Yan-yuze/probe-car/实现原理与答辩准备.md

# 探测小车 —— 实现原理与答辩准备

> 这份文档分两部分：**前半部分讲每个模块到底是怎么实现的**，后半部分是**模拟严苛答辩**（17 题，每题带答案）。
> 所有数值都来自代码实际取值和实机实测，不是估算。

---

# 第一部分：系统实现原理

## 一、系统总览

```
┌─────────────┐   MJPEG/HTTP    ┌──────────────────────┐
│  CyberCAM   │ ──────────────> │                      │
│ (摄像头板)   │     8081        │   电脑上的网页服务     │
└─────────────┘                 │      app.py          │
                                │        8765          │
┌─────────────┐   HTTP/WS       │                      │
│   ESP32-S3  │ <─────────────> │                      │
│             │     80 / 81     └──────────────────────┘
└──────┬──────┘                          ▲
       │ UART1 115200                    │ 浏览器
       │ GPIO17/18                       │
┌──────▼──────┐   I2C1 100kHz    ┌───────┴──────┐
│ STM32F103C8 │ ───────────────> │  电机驱动板   │
│             │   PB6/PB7        │  JGB37-520   │
│             │                  └──────────────┘
│             │   PWM 50Hz
│             │ ───────────────> 舵机 (PA6 / TIM3_CH1)
└─────────────┘
```

**为什么是三层而不是两层？**

电脑上的 `app.py` 不是多余的。ESP32 的 HTTP 服务在 WiFi 上，浏览器直接访问会遇到三个问题：跨域、断线重连、以及视频和控制在同一个页面里难以统一处理。电脑端做一层代理后：

- 浏览器只跟 `127.0.0.1:8765` 打交道，不存在跨域
- 视频（来自 CyberCAM）和控制（来自 ESP32）在同一个页面里统一呈现
- 可以在这里加**命令序号去重**（ESP32 上没有足够空间和便利做这件事）

**为什么控制链路要分两级超时？**

从浏览器到电机，中间隔了 WiFi、ESP32、UART、STM32 四个环节。任何一环断掉，如果没人兜底，小车就会带着上一次的速度一直跑下去。所以：

| 环节 | 超时 | 作用 |
| --- | --- | --- |
| 浏览器 | 每 180 ms 主动续发 | 证明"人还按着" |
| ESP32 | 500 ms 收不到浏览器消息 → 发 STOP | 兜住 WiFi 断、网页崩溃 |
| STM32 | 700 ms 收不到 ESP32 字节 → 主动刹车 | 兜住串口线断、ESP32 死机 |

180 < 500 < 700，留了足够余量，正常操作绝不会误触发。

---

## 二、STM32 侧实现原理

### 2.1 时钟树：72 MHz 是怎么来的

板上晶振 HSE = 8 MHz。`system_stm32f10x.c` 里的启动流程：

```
HSE 8MHz ──> PLL ×9 ──> SYSCLK 72MHz
                            │
              ┌─────────────┼─────────────┐
           AHB /1        APB2 /1       APB1 /2
              72MHz        72MHz        36MHz
              HCLK         PCLK2        PCLK1
```

关键在 **APB1 分频系数不为 1 时，挂在该总线上的定时器时钟 = PCLK1 × 2**。所以：

```
TIM3 时钟 = PCLK1 × 2 = 36MHz × 2 = 72MHz
```

这条规则是 STM32 特有的（目的是让定时器在主频降低时仍能获得较高计数频率），**也是答辩最容易问倒人的地方**。

### 2.2 SysTick：1 ms 毫秒基准

```c
SystemCoreClockUpdate();                    // 从 RCC 寄存器反推当前主频
SysTick_Config(SystemCoreClock / 1000);     // 72000 - 1 装入 LOAD
```

`SysTick` 是 Cortex-M3 内核自带的 24 位递减计数器，重装载值 71999，每 72000 个内核周期中断一次 = 1 ms。中断里只做 `g_ms_tick++`，`millis()` 直接返回这个变量，`Delay_ms()` 用无符号减法 `(uint32_t)(millis() - start) < ms` 判断——**用减法而不是比较大小，是为了让计数器溢出（约 49.7 天）时逻辑依然正确**。

### 2.3 电机驱动：I2C1 + 寄存器映射

驱动板是 JGB37-520 闭环电机，7 位地址 **0x26**，用寄存器方式配置：

| 寄存器 | 地址 | 内容 | 本车取值 |
| --- | --- | --- | --- |
| 类型 | 0x01 | u8 | 1（520 型号） |
| 死区 | 0x02 | u16 | 1500 |
| 每圈脉冲 | 0x03 | u16 | 11 |
| 减速比 | 0x04 | u16 | 30 |
| 轮径 | 0x05 | float | 68.0 mm |
| **速度** | 0x06 | 4×i16 大端 | 闭环速度 |
| **PWM** | 0x07 | 4×i16 大端 | 直接占空比 |

两个设计点：

1. **速度和 PWM 用不同寄存器**。正常行驶写 0x06（走闭环，编码器反馈保证 80 mm/s 真实线速度）；`Car_StopAll()` 写 0x07 全 0（直接切断 PWM）。如果停车也走速度环，PID 在收到 0 之后仍可能输出小占空比让车蠕动，**直接给 PWM 0 才是硬停**。

2. **左右电机符号相反**。两个电机镜像安装，所以 `RIGHT_WHEEL_FORWARD_SIGN = -1`、`LEFT_WHEEL_FORWARD_SIGN = +1`。差速转弯就是 `Car_SetWheelSpeed(-speed, speed)`——左轮后退、右轮前进，原地转。

3. **每个等待都有超时**。`wait_flag()` 和 `wait_event()` 都限时 50 ms，且检查 AF（应答失败）标志。原因见答辩第 12 题。

### 2.4 舵机：TIM3_CH1 硬件 PWM

**角度 → 脉宽**：

```c
pulse = 1000 + (angle * 1000 + 90) / 180;   // 单位 µs
```

- 0° → 1000 µs，180° → 2000 µs，线性映射
- 那个 `+90` 是**四舍五入**：除以 180 之前加 180 的一半，避免整数除法一律截断带来的系统偏小

**定时器配置**（寄存器直配，不经过标准库封装）：

```c
TIM3->PSC   = 72 - 1;        // 72MHz / 72 = 1MHz → 1 个计数 = 1µs
TIM3->ARR   = 20000 - 1;     // 20000 × 1µs = 20ms → 50Hz
TIM3->CCMR1 = (CCMR1 & 0xFF00) | 0x68;   // OC1M=110(PWM模式1) | OC1PE=1
TIM3->CCER |= TIM_CCER_CC1E;             // 通道 1 输出使能，高电平有效
TIM3->CCR1  = angle_to_pulse(88);        // 初始脉宽
TIM3->EGR    = TIM_EGR_UG;               // 产生更新事件，立刻载入 PSC/ARR
TIM3->CR1   |= TIM_CR1_ARPE | TIM_CR1_CEN;  // ARR 预装载 + 启动计数
```

**CCMR1 的 0x68 怎么来的**：bit4~6 是 OC1M（输出比较模式），`110` = PWM 模式 1；bit3 是 OC1PE（预装载使能）。`(0b110 << 4) | (1 << 3) = 0x60 | 0x08 = 0x68`。

**PA6 引脚配置**：GPIOA_CRL 的 bit27~24 = `0b1011`，即 CNF=10（复用推挽）、MODE=11（50 MHz 输出）。

**为什么不调用 `GPIO_PinRemapConfig()`**：TIM3 复位后默认就是不重映射，CH1 本来就在 PA6，没必要碰 AFIO。而且标准库那个函数的 DISABLE 分支里有一行 `tmpreg |= ~DBGAFR_SWJCFG_MASK`，会把 `AFIO_MAPR` 的 SWJ_CFG 位写成 `111`——一个多余的副作用，能避就避。

### 2.5 USART2：中断 + 主循环分工

- PA2 = TX（复用推挽），PA3 = RX（**上拉输入**）
- 115200 8N1，中断只做三件事：判标志、读数据、更新状态变量

中断里**绝不做**的事：I2C 通信、`printf`、延时。115200 下每个字节约 86.8 µs，中断必须在下一个字节到达前退出，否则 ORE（溢出）丢数据。

**协议帧**：

| 方向 | 帧 | 含义 |
| --- | --- | --- |
| ESP32→STM32 | `F/B/L/R/S\n` | 前进/后退/左转/右转/停 |
| ESP32→STM32 | `Pddd\n` | 舵机目标（30~150） |
| ESP32→STM32 | `Q\n` / `V\n` | 查询舵机角度 / 查询版本 |
| STM32→ESP32 | `A<cmd>\n` / `E<cmd>\n` | 执行成功 / 失败 |
| STM32→ESP32 | `T\n` | 失联超时通知 |
| STM32→ESP32 | `M0\n` / `M1\n` | 电机板未就绪 / 就绪 |
| STM32→ESP32 | `Pddd\n` | 当前舵机角度回执 |
| STM32→ESP32 | `V80SG90\n` | 固件版本 |
| STM32→ESP32 | `R\n` | 上电广播 |

**`Pddd` 帧解析是个状态机**，三个细节：

1. **STOP 优先级最高**。`'S'` 的判断放在 servo 帧分支**之前**，所以即使正在收 `P1`（半帧），来一个 `S` 也会立刻被当成停车命令处理——不会被半截舵机帧吞掉。

2. **坏帧丢弃而不是容错**。收到非数字非回车换行的字符时把 `digits` 设成 4（超过 3 就永远不会被接受），后续字符一律忽略直到换行。这样 `P1a2\n` 不会变成 `P12`。

3. **100 ms 帧超时**。如果 `P` 之后 100 ms 内没收全（比如串口被拔了一瞬间），主动放弃这一帧。否则一个半截帧会一直挂在那儿，把后面所有指令都吃掉。

### 2.6 失联保护：为什么是"停止发脉冲"

```c
#if SERVO_HOLD_TIMEOUT_MS > 0
if (!Servo_IsReleased() &&
    (uint32_t)(millis() - g_last_servo_command_ms) > SERVO_HOLD_TIMEOUT_MS) {
    Servo_Release();                     // CCR1 = 0
    servo_requested = 1;                 // 顺带回执给 ESP32
}
#endif
```

`Servo_Release()` 把 `CCR1` 写 0，PWM 模式 1 下 0% 占空比 = **PA6 恒低，一个脉冲都没有**。

**为什么不发 1500 µs**：因为连续旋转舵机的真实停止点每一颗都不一样。本车实测在 **1489 µs**，不是标称的 1500 µs。如果超时发 1500 µs，舵机不会停，而是以很小的偏移量慢慢爬。既然固件猜不准，**最安全的做法就是干脆不发脉冲**——舵机收不到脉冲就不驱动电机，一定停。

---

## 三、ESP32 侧实现原理

### 3.1 引脚选择的约束

板子是 YD-ESP32-S3 N16R8，`platformio.ini` 里 `board_build.arduino.memory_type = qio_opi`——**八线 PSRAM**。这决定了一批引脚不能用：

| 引脚 | 占用者 | 能否使用 |
| --- | --- | --- |
| 26~32 | SPI Flash | ❌ |
| **33~37** | **八线 PSRAM** | ❌ **本板特有** |
| 19 / 20 | 原生 USB D-/D+ | ❌ |
| 43 / 44 | UART0（板载 USB 转串口） | ❌ |
| 0 / 45 / 46 | strapping | ❌ |
| 48 | 板载 RGB 灯 | ❌ |
| **17 / 18** | 与 STM32 的 UART1 | ✅ 本项目占用 |
| **8 / 9** | AHT10 的 I2C | ✅ 本项目占用 |

`HardwareSerial carSerial(1)` 建的 UART1 通过 `carSerial.begin(baud, SERIAL_8N1, RX, TX)` 重映射到 18/17。

另外 `ARDUINO_USB_CDC_ON_BOOT=0`，所以 `Serial` 走的是 UART0（板载 USB 转串口芯片），日志在 COM7 上能看到。

### 3.2 WiFi 双模与状态机

```c
WiFi.mode(useStation ? WIFI_AP_STA : WIFI_AP);
WiFi.softAP(CAR_AP_SSID, CAR_AP_PASSWORD, 6, false, 2);   // 信道 6，2.4GHz
WiFi.begin(WIFI_SSID, WIFI_PASSWORD);                     // 8 秒超时
```

**同时开热点和 STA**，好处是：连不上路由器时还能用自建热点 `192.168.4.1` 控制，不会变砖。`useStation` 由 `strlen(WIFI_SSID) > 0` 决定——**留空就退化成纯 AP 模式**，这也是仓库里默认的配置。

### 3.3 与 STM32 的通信与状态推断

```c
bool isStm32Online() { return stm32EverSeen && (millis() - lastStm32RxMs <= 2500UL); }
bool hasServoFirmware() { return stm32Version == "V80SG90"; }
```

两个关键设计：

1. **`stm32EverSeen` 和"最后一次收到时间"分开**。刚上电时 STM32 还没说话，不应该报"掉线"（会误报）。只有**曾经收到过**、且**超过 2.5 秒没再收到**才算掉线。

2. **用固件版本号做能力门控**。`hasServoFirmware()` 比对 `V80SG90`。旧版 STM32（`V80S`）没有舵机功能，网页会**禁用舵机按钮**而不是发过去一个它看不懂的命令。这种"能力协商"比"发了再说"健壮得多。

另外 `processStm32Line()` 收到 `R`（STM32 上电广播）时会**清空缓存的版本号和角度**——所以热插拔 STM32 之后 ESP32 会自动重新同步，不需要手动重启 ESP32。

### 3.4 AHT10 温湿度驱动

**通信协议**（I2C 地址 0x38）：

| 步骤 | 字节 | 说明 |
| --- | --- | --- |
| 初始化 | `0xE1 0x08 0x00` | AHT10 的校准命令 |
| 初始化 | `0xBE 0x08 0x00` | AHT20 的校准命令（备用） |
| 触发测量 | `0xAC 0x33 0x00` | 每次读数据前都要发 |
| 等待 | ≥ 80 ms | 代码取 90 ms 留余量 |
| 读数据 | 6 字节 | 见下 |

**状态字节两个位**：bit7 = busy（还在测量），bit3 = calibrated（已校准）。

**6 字节数据格式**：

```
b[0] = 状态
b[1] b[2] b[3]高4位  → 湿度 20 位
b[3]低4位 b[4] b[5]  → 温度 20 位
```

```c
rawHum  = (b[1] << 12) | (b[2] << 4) | (b[3] >> 4);              // 20 位
rawTemp = ((b[3] & 0x0F) << 16) | (b[4] << 8) | b[5];           // 20 位

humidity    = rawHum  * 100.0f / 1048576.0f;        // 2^20 = 1048576
temperature = rawTemp * 200.0f / 1048576.0f - 50.0f;
```

温湿度和温度**共用 b[3] 这一个字节**（各占 4 位），这是 AHT10 数据手册里最容易写错的地方。

**两个实现要点**：

1. **兼容 AHT20**。市面上标着 AHT10 的模块里装的经常其实是 AHT20，两者地址和读数据格式完全一样，只有初始化命令不同（0xE1 vs 0xBE）。驱动两个都试，谁把 calibrated 位置起来就用谁。

2. **非阻塞状态机**。AHT10 一次测量要 80 ms。如果用 `delay(80)`，这 80 ms 里 HTTP 服务器不响应、串口不转发，网页会卡顿。所以拆成状态：

   ```
   IDLE ──(到 2 秒)──> 发 0xAC ──> WAITING ──(过 90 ms)──> 读 6 字节 ──> IDLE
   ```

   每次 `loop()` 只推进一步，主循环始终保持响应。

3. **I2C 扫描器**。启动时扫 0x08~0x77，把找到的地址放进状态 JSON。传感器没接时网页直接显示"I2C 上扫到：无"，**把接线问题变成看得见的信息**，而不是一句"读取失败"。

---

## 四、电脑端实现原理

### 4.1 app.py：代理 + 防重放

`app.py` 只用 Python 3 标准库（`http.server.ThreadingHTTPServer`），不装任何第三方包。

**命令序号去重**是它最有价值的部分：

```python
client_id = payload.get("client_id")     # 每个浏览器标签页一个 UUID
sequence  = payload.get("sequence")      # 单调递增

if sequence <= sequence_map.get(client_id, 0):
    return {"ok": True, "skipped": True}   # 旧命令直接丢弃，不转发
sequence_map[client_id] = sequence
```

解决的问题是**乱序**：按住前进突然松手，`STOP` 和前一个 `FORWARD` 可能几乎同时发出，网络上到达顺序不保证。如果 `STOP` 先到、`FORWARD` 后到，车就会**松开手还在跑**。有了序号，`FORWARD` 的序号比 `STOP` 小，直接被丢弃。

**运动和舵机用两把独立的锁 + 两张独立的序号表**。如果共用一把锁，一个慢的舵机请求会阻塞住 `STOP`；共用一张表则舵机的序号会把停车指令挤掉。

**安全校验**：要求 `Content-Type: application/json` **且** `X-Car-UI: 1` 自定义头。别的网页想通过 CSRF 让小车动起来时，浏览器发跨域请求会先发 CORS 预检，自定义头过不了，请求根本发不出来。请求体限制 1~128 字节。

**视频转发**用 `source.read1(16 * 1024)` 而不是 `read(16384)`：`read` 会一直等到凑满 16 KB 才返回，会引入额外延迟；`read1` 有多少返回多少。

### 4.2 前端：按住才转是怎么实现的

```js
servoLeft.addEventListener('pointerdown', e => {
  servoLeft.setPointerCapture?.(e.pointerId);   // 手指滑出按钮也能收到 pointerup
  startServo('LEFT');                           // 立刻发一次 + 每 180ms 续发
});
window.addEventListener('pointerup', e => { if (e.pointerId === activeServoPointerId) stopServo(); });
window.addEventListener('blur', () => stopServo(true));
document.addEventListener('visibilitychange', () => { if (document.hidden) stopServo(true); });
window.addEventListener('pagehide', () => stopServo(true));
```

四个细节：

1. **`setPointerCapture`**：手指按住按钮后滑出去再松开，如果不捕获指针，`pointerup` 会派发给别的元素，`stopServo` 就收不到，舵机会一直转。

2. **`pointerup` 绑在 window 上而不是按钮上**：在页面任何地方松手都能停。

3. **`blur` / `visibilitychange` / `pagehide` 三重兜底**：切到别的窗口、按手机锁屏、直接关标签页，都会停。`pagehide` 时 fetch 带 `keepalive: true`，保证这个最后的 `STOP` 在页面卸载过程中也能发出去。

4. **`servoPending` / `servoQueued` 合并请求**：同一时刻只允许一个请求在飞，飞行期间的变化只记一个"待发"标记。这样既不会堆积请求，又**保证停止指令不会被丢弃**。

### 4.3 舵机方向与转速的标定过程

连续旋转舵机的物理规律：

```
转速 ∝ |脉宽 − 真实停止点|
方向 = sign(脉宽 − 真实停止点)
```

一开始用对称于 **1500 µs** 的两个值（1417 / 1583）。如果舵机的真实停止点正好是 1500 µs，两边速度就该一样。**实测右转偏快**，说明停止点比 1500 µs 低。

设真实停止点比 1500 µs 低 `d`：

```
左转偏移 = 83 − d      右转偏移 = 83 + d
速度比 = (83+d)/(83−d)
```

"只快一点点"约对应 1.13 倍，解得 `d ≈ 5~11 µs`。于是把基准从 **90（1500 µs）调到 88（1489 µs）**：

| 按钮 | 角度 | 脉宽 | 离真实停止点 |
| --- | --- | --- | --- |
| 左转 | 103 | 1572 µs | 83 µs |
| 停止 | 88 | 1489 µs | 0 |
| 右转 | 73 | 1406 µs | 83 µs |

两边偏移相等 → 转速一致。

**代码上的关键约束**：左右两个方向**必须**由同一个基准加减同一个偏移得出：

```js
if (servoRotating === 'LEFT')  return clampServoAngle(SERVO_STOP_ANGLE + SERVO_SPAN);
if (servoRotating === 'RIGHT') return clampServoAngle(SERVO_STOP_ANGLE - SERVO_SPAN);
```

曾经出过一次 bug：两个方向写成两个独立常量，`SERVO_RIGHT_ANGLE` 被误改成和左转相同的值，结果两个按钮发出**完全相同**的脉宽，左右都往同一边转。用"基准 ± 偏移"的形式，这种错误在结构上就写不出来了。

### 4.4 关于"回正"

**连续旋转舵机做不到精确回正，这是硬件限制。** 它的内部角度电位器在改成 360° 时已经被拆掉/短接，控制环调节的是**速度**而不是**位置**——它没有任何绝对位置参考，不知道自己转到哪了。

理论上只有两种近似：按时间对冲（累计转动时长再反向转同样久，误差会累积），或者往机械限位顶（每次都顶到同一个位置，精确但会让舵机堵转）。**要精确回位只能换普通位置舵机**（带电位器反馈的那种）。

---

## 五、CyberCAM 视频服务

跑在摄像头板上，也是纯标准库 + OpenCV。

**`LatestJpeg` 是核心**——只保存最新一帧：

```python
def publish(self, jpeg):        # 采集线程
    with self.condition:
        self.jpeg = jpeg
        self.sequence += 1
        self.condition.notify_all()

def wait_after(self, sequence, stop):   # 推流线程
    with self.condition:
        if self.sequence <= sequence and not stop.is_set():
            self.condition.wait(timeout=1.0)
        return self.sequence, self.jpeg
```

**为什么只存最新一帧**：如果做成队列，浏览器一卡，帧就在队列里堆积，越积越多，最后延迟几秒甚至内存爆掉。只存最新帧的话，慢的客户端会**主动丢帧**而不是积压——延迟恒定，这才叫实时。

`/health` 返回 `frames` 和 `age_ms`，`ok` 要求 `age_ms < 2000`——**用"数据有多旧"判断健康，而不是"有没有数据"**。摄像头卡死但进程还活着的情况，只有看 age 才能发现。

采集节奏用 `next_frame += period` 再 `stop.wait(remaining)`：累加式计时避免误差累积，`stop.wait` 代替 `sleep` 让退出信号能立刻响应。

---

# 第二部分：答辩模拟（17 题）

> 下面是"如果不是自己写的就答不上来"的问题。每题先给答案，再给**常见错误回答**（老师会追问的地方）。

---

## Q1. 你的 TIM3 计数频率是多少？怎么算出来的？

**答**：1 MHz，也就是一个计数 = 1 微秒。

TIM3 挂在 APB1 上。系统时钟 72 MHz，APB1 分频系数是 2，所以 PCLK1 = 36 MHz。但 STM32 有个规则：**APB 分频系数不为 1 时，该总线上定时器的时钟等于 APB 时钟的 2 倍**，所以 TIM3 的时钟是 72 MHz。

```c
TIM3->PSC = 72 - 1;      // 72MHz / 72 = 1MHz
TIM3->ARR = 20000 - 1;   // 20000 × 1µs = 20ms → 50Hz
```

> ❌ 常见错误：直接说 36 MHz。这会把 PWM 周期算成 40 ms（25 Hz），舵机会抖。

---

## Q2. 为什么 PSC 要写 71 而不是 71.0 或者 72000000/1000000？

**答**：因为分频器是"计数值"语义，不是"倍数"语义。STM32 的预分频器是**从 0 开始计数到 PSC 然后溢出**，所以实际分频比 = `PSC + 1`。要 72 分频就得写 71。

我在代码里没有写死 71，而是算出来的，这也是有意为之：

```c
clock = tim3_clock();                       // 读 RCC 反推实际时钟
TIM3->PSC = (uint16_t)(clock / 1000000U - 1U);
```

这样即使换一颗晶振不同的板子、或者 HSE 起振失败自动降级到 HSI 64 MHz，PWM 频率依然是准确的 50 Hz，不需要改代码。

> 追问：如果忘了减 1 会怎样？→ PSC = 72 → 73 分频 → 986 kHz → 周期变成 20.28 ms → 49.3 Hz。误差不大但没必要。

---

## Q3. 角度转脉宽的公式里，为什么除以 180 之前要先加 90？

**答**：那是**四舍五入**。

```c
pulse = 1000 + (angle * 1000 + 90) / 180;
```

0°~180° 对应 1000 µs~2000 µs，所以 1° = 1000/180 ≈ 5.556 µs。整数除法是**向下取整**，如果直接除，每一档都会偏小最多 1 µs，而且误差方向一致（有系统性偏差）。先加 180 的一半（90）再除，就变成四舍五入，误差变成 ±0.5 µs 且不偏。

代入验证：angle = 88 → 1000 + (88000+90)/180 = 1000 + 489 = **1489 µs**。

---

## Q4. 脉宽 1500 µs 是舵机的中位，那你为什么用 1489 µs 当停止点？

**答**：因为**1500 µs 是标称值，不是这颗舵机的实际值**。

连续旋转舵机的转速正比于 |脉宽 − 真实停止点|。我一开始按标称值对称下发 1417 µs（左）和 1583 µs（右），两边离 1500 µs 都是 83 µs，理论上转速应该完全一样。**实测右转明显偏快**，说明真实停止点不在 1500 µs。

设真实停止点比 1500 µs 低 d，则左转偏移 = 83−d，右转偏移 = 83+d。"只快一点点"约对应速度比 1.13，解 `(83+d)/(83−d) = 1.13` 得 d ≈ 5~11 µs。

所以把基准从 90（1500 µs）挪到 **88（1489 µs）**，两个方向变成 ±83 µs 对称分布，转速就一致了。

> 追问：你怎么确定是 5~11 而不是别的？→ 我无法测量，只能靠"快一点点"这个主观描述反推。所以这是**标定值**，不是理论值。如果还差一点，往 87 或 89 调一格（1 个角度 ≈ 5.6 µs）就行。

---

## Q5. 你的代码里没有调用 GPIO_PinRemapConfig，TIM3_CH1 为什么会在 PA6 上？

**答**：因为**不重映射就是默认状态**。

STM32F103 的 TIM3 复用功能有三档：不重映射（CH1~CH4 = PA6/PA7/PB0/PB1）、部分重映射（PB4/PB5/PB0/PB1）、完全重映射（PC6~PC9）。这个设置存在 `AFIO_MAPR` 的 TIM3_REMAP 位（bit11:10），**复位值是 0 = 不重映射**，所以 CH1 天生就在 PA6。

我刻意不调用 `GPIO_PinRemapConfig()` 是因为看了标准库的实现，它的 DISABLE 分支里有这么一行：

```c
tmpreg |= ~DBGAFR_SWJCFG_MASK;    // 结果是把 AFIO_MAPR 的 bit24~27 置 1
```

而 `AFIO_MAPR` 的 bit26:24 是 **SWJ_CFG**——控制 JTAG/SWD 调试口的配置位。虽然 `111` 这个值在手册里是"no effect"（保留值，不生效），但这是一个**和重映射毫无关系的副作用**，而且一旦哪天 ST 改了保留值的含义就会出问题。既然默认值就是我要的，那就不碰它。

> 这一题最能看出是不是自己写的：只看"代码能跑"的人不会注意到那个副作用。

---

## Q6. 舵机失联保护，为什么是"停止发脉冲"而不是"发 1500 µs 让它停"？

**答**：因为 1500 µs **不是这颗舵机的停止点**（见 Q4，实测是 1489 µs）。

`Servo_Release()` 把 `CCR1` 写 0，PWM 模式 1 下 0% 占空比 = **PA6 恒低，一个脉冲都没有**。舵机的控制芯片收不到脉冲就不驱动电机，一定会停。

如果超时发 1500 µs，舵机会收到一个偏离真实停止点 11 µs 的脉宽，它会**以很小的速度慢慢爬**——看起来像"停不下来"，而且是持续堵转，对舵机不好。

固件猜不准每颗舵机的真实停止点，**"不发脉冲"是唯一不依赖这个未知量的安全动作**。

> 代价：停下来后没有保持力矩。对连续旋转舵机没影响；如果以后换成位置舵机，要把 `SERVO_HOLD_TIMEOUT_MS` 改成 0 关掉这个保护。

---

## Q7. 你的两级失联保护具体是怎么配合的？为什么是 180 / 500 / 700 这三个数？

**答**：

| 环节 | 时间 | 触发条件 | 动作 |
| --- | --- | --- | --- |
| 浏览器 | 180 ms | 按住期间定时续发 | 证明"人还按着" |
| ESP32 | 500 ms | 收不到浏览器消息 | 向 STM32 发 STOP |
| STM32 | 700 ms | 收不到 ESP32 的字节 | 主动刹车并停车 |

设计依据是**层层留余量**：

- 180 ms 是续发周期，必须**明显小于** 500 ms，否则网络抖动一下 ESP32 就误判了。留了 2.7 倍余量。
- ESP32 的 500 ms 必须**小于** STM32 的 700 ms。这样正常失联时是 ESP32 先主动停车（分层优雅），STM32 的 700 ms 只是最后一道防线（串口线断了、ESP32 死机时才触发）。
- 同时 180 ms 也不能太短，否则每秒钟 5~6 个 HTTP 请求，ESP32 的 WebServer 会吃力。

**还有一个容易被忽略的点**：`Pddd`（舵机命令）和 `Q`/`V`（查询）**不刷新行驶超时计时器**。否则用户在舵机面板上一直拖动滑条，就会有无穷多个舵机命令不停地喂狗，把"车该停了"这件事永远推迟下去。舵机指令绝对不能成为让车继续行驶的理由。

> 这是安全设计上的一个真实陷阱，不是理论问题。

---

## Q8. USART2 中断服务函数里为什么不能调用 I2C 或者 printf？

**答**：因为它必须在**下一个字节到达之前**退出。

115200 baud 下，1 位 = 1/115200 ≈ 8.68 µs，一个字节（1 起始位 + 8 数据位 + 1 停止位）= **86.8 µs**。

中断里的 `USART_ReceiveData()` 会把 RXNE 标志清掉，下一个字节再进来时如果 RXNE 还是 1（说明上次的没被读走），硬件就会置 **ORE（溢出错误）**，那个字节**永久丢失**。

如果在中断里做一次 I2C 传输，光等待事件就可能几毫秒——相当于几十个字节全丢。`printf` 同理，串口输出本身就要排队发送。

所以我的中断里只有：

```c
void USART2_IRQHandler(void) {
    if (USART_GetITStatus(USART2, USART_IT_RXNE) != RESET) {
        char c = (char)(USART_ReceiveData(USART2) & 0xFF);
        // ... 纯内存操作的帧状态机 ...
    }
}
```

真正的活（I2C 下发、回执发送）全在 `main()` 的主循环里，通过 `volatile` 标志位交接。**中断只负责"记下来"，主循环负责"干活"。**

---

## Q9. 描述一下你解析 `P090\n` 这个舵机帧的完整过程，包括出错怎么处理。

**答**：是一个跨多次中断的**状态机**，状态存在全局变量里：

```
g_servo_receiving    是否在帧中
g_servo_digits       已收数字个数
g_servo_value        累加值
g_servo_frame_started_ms  帧开始时间
```

流程：

1. 收到 `'P'` → `receiving=1, digits=0, value=0`，记录开始时间
2. 收 `'0'` → 是数字且 digits<3 → `value = 0*10+0 = 0, digits=1`
3. 收 `'9'` → `value = 0*10+9 = 9, digits=2`
4. 收 `'0'` → `value = 9*10+0 = 90, digits=3`
5. 收 `'\n'` → 检查 `digits==3 && 30<=value<=150` → 通过，置 `g_servo_pending=1`

**三种异常**：

| 情况 | 处理 |
| --- | --- |
| 收到非数字字符（如 `P1a2\n`） | `digits = 4`（超过 3），后续一律忽略到换行，整帧作废 |
| 收满 3 位后还有第 4 位（如 `P1234\n`） | digits 已经是 3，不再累加，也不置错——但换行时会因为长度不是 3 而拒收 |
| 帧收了一半就断了 | 进中断时检查 `millis() - frame_started_ms > 100`，超时则 `receiving=0` 放弃这一帧 |

**最关键的一点**：`'S'` 的判断放在整个 servo 分支**之前**：

```c
if (command == 'S') {              // 最高优先级，先判
    g_servo_receiving = 0;         // 顺手把半截舵机帧丢掉
    ...
} else if (g_servo_receiving) {    // 然后才是帧内字符
    ...
}
```

这样"停车"永远不会被一个半截舵机帧挡住。如果把 `'S'` 放在帧内分支后面，收到 `P1` 再来 `S`，`S` 就会被当成"帧里的非法字符"而被忽略——**车停不下来**。

---

## Q10. PA3 你配成了上拉输入，为什么？配成浮空输入会怎样？

**答**：因为**串口空闲电平是高电平**。

UART 的起始位是"从高到低"的跳变。如果 PA3 浮空，引脚电平随机漂移，一旦低于阈值，USART 就会认为检测到了起始位，开始采样 8 位数据——**收到一堆随机的垃圾字节**。

更糟的是，这些垃圾字节会进入我的帧状态机。如果恰好组成了一个 `'F'`，车就自己跑起来了。

配成 `GPIO_Mode_IPU`（输入上拉）后，拔掉串口线时引脚被内部上拉电阻稳定在高电平（空闲态），不会产生伪起始位。这是一个**"防止接线松了导致车失控"**的防护，不是可有可无的配置。

---

## Q11. I2C 为什么必须用开漏输出，推挽为什么不行？

**答**：因为 I2C 是**线与（wired-AND）总线**，多个设备共享 SDA/SCL 两根线。

推挽输出有强上拉和强下拉两种状态。假设主机想输出高（推挽拉高到 3.3 V），同时从机想输出低（拉低到 0 V），两个 MOS 管直接对电源短路——**瞬时大电流，可能烧毁引脚**。

开漏输出只能主动拉低，或者"放开"（高阻态）。高电平由总线上的**上拉电阻**提供。这样：

- 任何设备拉低 → 总线就是低
- 所有设备都放开 → 上拉电阻把总线拉高

天然实现了线与逻辑。所以配置必须是：

```c
gpio.GPIO_Mode = GPIO_Mode_AF_OD;    // 复用开漏，不是 AF_PP
```

上拉电阻一般在电机驱动板上已经带了。如果换成推挽，短时间可能"看起来能用"，但一旦两个设备同时驱动就会出问题——这是典型的"能跑但不该这么写"。

---

## Q12. 电机的每个 I2C 操作你都加了 50 ms 超时，为什么？不加会怎样？

**答**：因为**不加会让整个主循环卡死**。

标准库的 `I2C_CheckEvent()` 是个 `while` 死等。如果从机在传输过程中被复位（比如电机板供电瞬间跌落），它可能把 SDA 一直拉低。这时主机等待 BUSY 标志清零会**永远等不到**，`main()` 里的整个主循环就停在那里了。

后果是连锁的：串口不再响应（ESP32 判它掉线）、舵机失联保护也走不到（因为主循环没在跑）、LED 不再闪烁——**整块板子假死**。

所以我把所有等待都包了一层：

```c
static uint8_t wait_event(uint32_t event) {
    uint32_t start = millis();
    while (I2C_CheckEvent(MOTOR_I2C, event) != SUCCESS) {
        if (I2C_GetFlagStatus(MOTOR_I2C, I2C_FLAG_AF) == SET) {  // 应答失败，早点退出
            I2C_ClearFlag(MOTOR_I2C, I2C_FLAG_AF);
            return 1;
        }
        if ((uint32_t)(millis() - start) > I2C_TIMEOUT_MS) return 1;  // 兜底
    }
    return 0;
}
```

**同时检查 AF 标志和超时**：AF 是"从机没应答"，这是最常见的失败，能立刻判断而不用等满 50 ms；超时是兜底，防止 AF 也没置起来的情况。

超时返回后，主循环把 `motor_ready` 置 0，**舵机和串口继续工作**（设计上电机板缺失不应该拖累舵机），并每 2 秒重试初始化。

---

## Q13. 你的停车为什么写 0x07 寄存器，行驶却写 0x06？不能统一吗？

**答**：不能，因为它们是**两种不同的控制模式**。

| 寄存器 | 模式 | 写 0 的效果 |
| --- | --- | --- |
| 0x06 | 闭环速度 | 目标速度 0，但 PID 仍在运行，可能输出小占空比 |
| 0x07 | 直接 PWM | 占空比 0，**电机彻底断电** |

如果停车也走速度环（写 0x06 全 0），PID 控制器会因为编码器还有微小读数而输出一点点 PWM 试图"修正"，表现就是**车停下来后还在轻微蠕动**。对于"松开手必须立刻停"的安全要求，这是不可接受的。

所以 `Car_StopAll()` 直接写 PWM 寄存器给 0，**绕过 PID 硬停**。

> 追问：那这样停车后位置会漂吗？→ 会。但对探测小车来说，可靠停车比精确停位重要得多。

---

## Q14. app.py 里的命令序号去重解决什么问题？举个具体场景。

**答**：解决**乱序到达**和**重复发送**。

具体场景：用户按住"前进"约 2 秒，然后松手。这时浏览器已经发了约 11 个 `FORWARD`，最后发一个 `STOP`。

在网络上（尤其是 WiFi），这 12 个请求**到达顺序不保证**。完全可能 `STOP` 先到、第 11 个 `FORWARD` 后到。如果按到达顺序执行，最终结果就是**车在前进**——用户明明松手了，车却在跑。

有了序号就解决了：

```python
if sequence <= sequence_map.get(client_id, 0):
    return skipped      # 序号比已处理的小 → 是迟到的旧命令，丢弃
```

第 11 个 `FORWARD` 的序号比 `STOP` 小，所以它会被判为"迟到"，**直接丢弃不转发**。

另外 `client_id` 是每个浏览器标签页一个 UUID，所以：
- 多个标签页同时打开不会互相干扰（各自的序号独立递增）
- 某个标签页刷新后拿到新 UUID，序号重新从 1 开始，不会有"新页面序号比旧页面小所以命令全被丢弃"的问题

---

## Q15. ESP32-S3 上你为什么避开 GPIO33~37？换个板子能用吗？

**答**：因为**这块板子的 PSRAM 是八线的**。

`platformio.ini` 里：

```ini
board_build.arduino.memory_type = qio_opi
```

`opi` = Octal PI，八线 PSRAM。普通 ESP32-S3 的 SPI Flash 占 GPIO26~32（7 根线）。而**八线 PSRAM 额外占用 GPIO33~37**（多出来的 5 根数据线）。

这 5 个脚被 PSRAM 控制器独占，如果当普通 IO 用，轻则读写异常，重则**程序跑飞或无法启动**。而且这类故障很隐蔽——可能只是偶尔死机。

换板子要看具体配置：
- **N8R2**（八线 PSRAM）→ 33~37 同样不能用
- **N16R8**（我用的这个）→ 33~37 不能用
- 没有 PSRAM 或四线 PSRAM 的板子 → 33~37 可以用

我的引脚选择逻辑是把所有**绝对禁区**列出来再选：strapping（0/45/46）、原生 USB（19/20）、UART0（43/44）、Flash（26~32）、八线 PSRAM（33~37）、板载 RGB（48），然后避开已占用的 17/18，最后选 GPIO8/9 做 I2C。

---

## Q16. AHT10 一次要读 6 个字节，你怎么解析温湿度？为什么要做数值合法性检查？

**答**：数据格式是**跨字节共享**的 20 位值：

```
b[0]  = 状态字节（bit7=busy, bit3=calibrated）
b[1]  b[2]  b[3]的高4位  → 湿度高 20 位
b[3]的低4位  b[4]  b[5]  → 温度 20 位
```

注意 **b[3] 被湿度和温度各用了一半**，这是 AHT10 手册里最容易写错的地方：

```c
rawHum  = (b[1] << 12) | (b[2] << 4) | (b[3] >> 4);          // 湿度：低 4 位在 b3 高半字节
rawTemp = ((b[3] & 0x0F) << 16) | (b[4] << 8) | b[5];        // 温度：高 4 位在 b3 低半字节

humidity    = rawHum  * 100.0f / 1048576.0f;      // 2^20 = 1048576
temperature = rawTemp * 200.0f / 1048576.0f - 50.0f;
```

温度公式里的 `-50` 是因为 AHT10 的量程是 −40~80 °C，而 20 位满量程映射的是 0~200 的"扩展量程"，所以要先减 50。

**合法性检查的必要性**：如果 SDA 接触不良，读到的是随机的 6 个字节，算出来可能是 −200 °C 或者 3000 %RH。这种数据一旦显示在网页上，用户会以为程序坏了。所以我加了两道：

```c
if ((data[0] & 0x80) != 0) { errorCode = 4; return; }   // busy 还在测量，数据无效
if (humidity < 0 || humidity > 100 || temperature < -40 || temperature > 80) {
    errorCode = 4; return;
}
```

**并且只在校验通过后才更新 `reading_`**，所以网页上永远不会出现某个瞬间的离谱数值——要么是上一次的有效值，要么显示"未检测到"。

---

## Q17. 如果你的舵机能精确回正，你会怎么实现？现在为什么做不到？

**答**：**现在做不到，是硬件决定的，不是软件问题。**

连续旋转舵机的内部结构是：把位置舵机的**角度电位器拆掉**（或换成两个固定电阻），这样反馈信号就不再随输出轴变化。控制环拿到的"当前位置"永远是个定值，于是：

- 脉宽 = 停止点 → 误差 0 → 不转
- 脉宽 > 停止点 → 恒定误差 → 持续正转
- 脉宽 < 停止点 → 反向恒定误差 → 持续反转

**它完全不知道自己的绝对角度**，没有任何位置参考（没有电位器、没有编码器、没有索引标记）。所以"转回开机时的角度"缺少必要的物理信息。

**如果换成普通位置舵机**（带电位器反馈的 SG90 / MG90S 标准版），实现就非常简单：

```c
Servo_SetAngle(90);    // 一个函数调用，硬件自动闭环转过去
```

因为位置舵机的控制环是：`误差 = 目标脉宽对应角度 − 电位器读数`，电位器读数就是绝对位置，误差归零就停在那里。回正就是"再发一次开机时那个角度"。

**现在的两种近似方案及其缺陷**：

| 方案 | 精度 | 问题 |
| --- | --- | --- |
| 按时间对冲（累计转动时长再反向转） | 差，误差累积 | 转速受电压、负载、温度影响，每次转向都有误差 |
| 顶到机械限位 | 好（每次同一位置） | 会让舵机堵转，长时间顶会发热甚至烧齿轮 |

我最终没有实现，因为用户要的是"精确回到开机角度"，而这两种都给不了——**做一个精度不够的功能比不做更糟**，用户会以为它准而后悔。

---

# 附录：实测验证记录

以下数据都是用 ST-Link 在芯片运行状态下读寄存器得到的（`STM32_Programmer_CLI -c port=SWD mode=hotplug`，热插拔模式，不停 CPU）。

```
RCC_CFGR   = 0x001D040A   SW/SWS=PLL, PLLSRC=HSE, PLLMULL=9, APB1=/2  → 72MHz
GPIOA_CRL  = 0x4B448B44   PA6 半字节 = 0xB = 复用推挽 50MHz
TIM3 CR1   = 0x00000081   CEN=1（计数器运行）, ARPE=1
TIM3 CCMR1 = 0x00000068   OC1M=110（PWM 模式1）, OC1PE=1
TIM3 CCER  = 0x00000001   CC1E=1（通道1输出使能）
TIM3 PSC   = 71           计数频率 1MHz
TIM3 ARR   = 19999        PWM 频率 50.00Hz，周期 20.00ms
TIM3 CCR1  = 1489         停止点（实测标定值）
```

命令与脉宽的对应关系：

| 命令 | 角度 | CCR1 实测 | 理论值 |
| --- | --- | --- | --- |
| 左转 | 103 | 1572 µs | 1572 |
| 停止 | 88 | 1489 µs | 1489 |
| 右转 | 73 | 1406 µs | 1406 |
| （旧）满速右 | 150 | 1833 µs | 1833 |
| （旧）满速左 | 30 | 1167 µs | 1167 |

失联保护验证：停止发指令 2 秒后读 `CCR1 = 0`，确认已进入"停止发脉冲"状态。
