Yan-yuze/probe-car/verification/sg90-controls.png

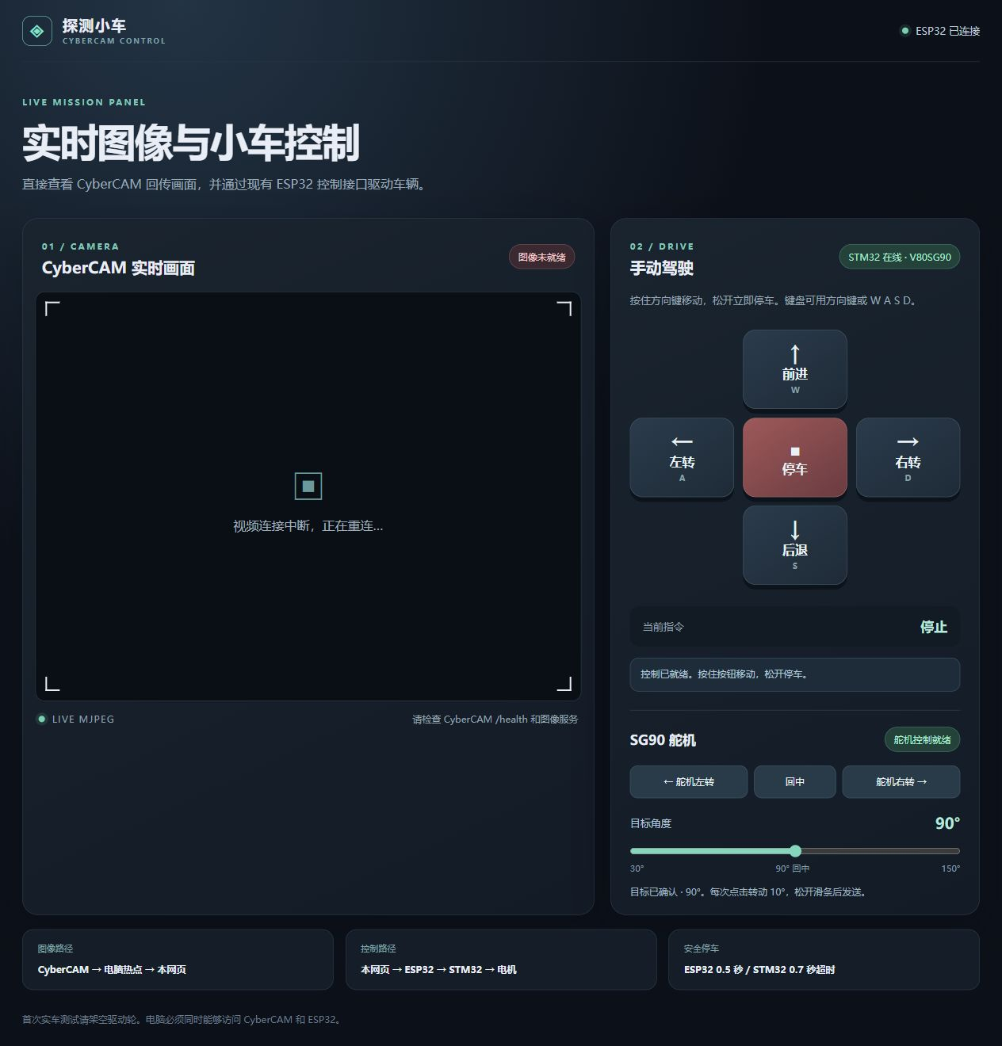
verification/sg90-controls.png
