Yan-yuze/probe-car/(commit log)

2026-10-02 初始提交：探测小车（CyberCAM 实时画面 + ESP32 网页控制 + STM32 电机与舵机）
    电脑端
    - app.py：本机网页服务，转发 CyberCAM 的 MJPEG，代理 ESP32 的控制与状态接口
    - web/：按住才转的方向控制、舵机方向与转速标定、AHT10 温湿度显示
    ESP32-S3（PlatformIO / Arduino）
    - WiFi 双模（自建热点 + 连接电脑热点）、HTTP / WebSocket、状态 JSON
    - 与 STM32 的 UART 桥、命令序号与过期保护
    - AHT10 温湿度驱动（I2C，兼容 AHT20，非阻塞状态机）
    STM32F103（Keil MDK）
    - 电机驱动板 I2C 控制（PB6/PB7）
    - 舵机 PWM（PA6 = TIM3_CH1，50Hz）
    - USART2 协议（PA2/PA3，115200）
    - 两级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
2026-10-02 添加 MIT LICENSE 和实现原理与答辩准备文档
    - LICENSE：MIT
    - 实现原理与答辩准备.md：17 道答辩模拟题及答案，
    并逐模块说明实现细节（STM32 时钟树/PWM 标定/串口帧状态机/I2C 容错、
    ESP32 引脚约束/AHT10 数据格式/状态机、app.py 序号去重、前端按住才转）
    - README：在项目结构后加入该文档的入口链接
